vlaate/DobsonianDSC/dobDSC-back.jpg

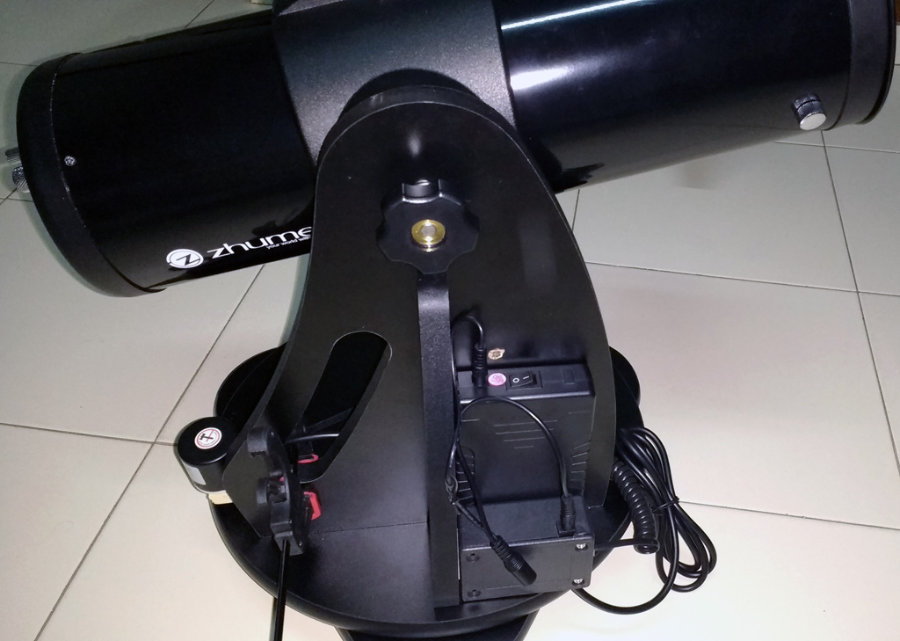
dobDSC-back.jpg
