vlaate/DobsonianDSC/dobDSC-front.jpg

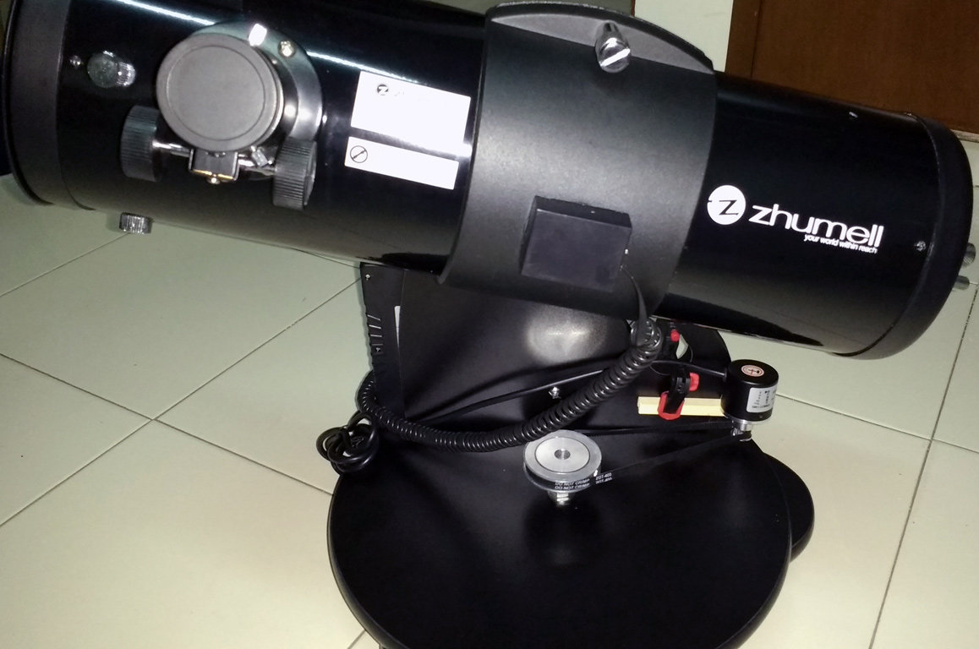
dobDSC-front.jpg
