vlaate/DobsonianDSC/dobDSC-upclose.jpg

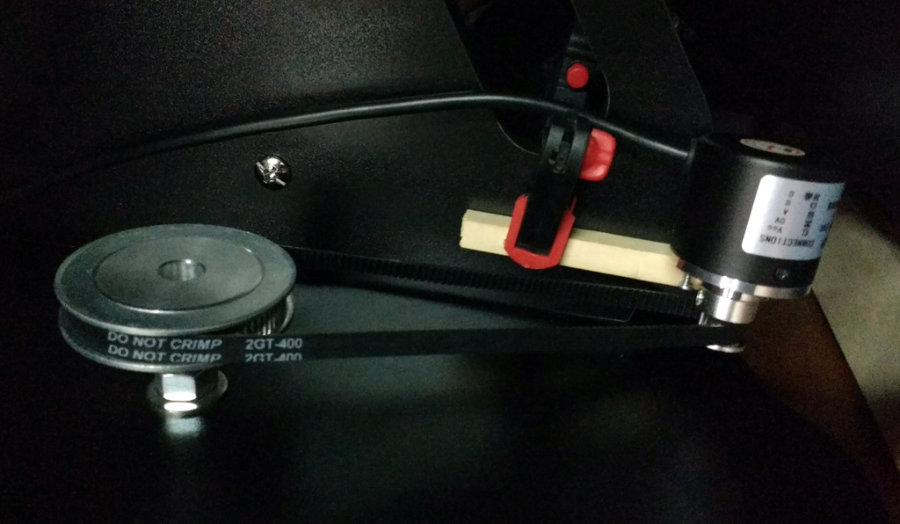
dobDSC-upclose.jpg
