vlaate/DobsonianDSC/img/9.png

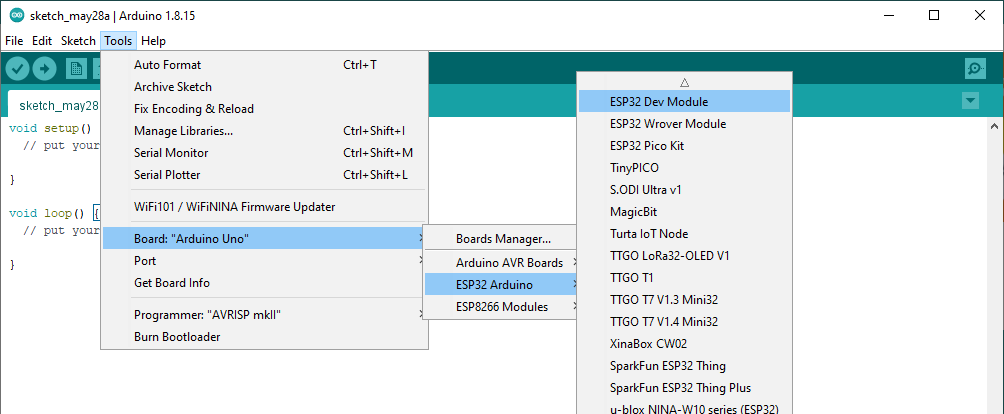
img/9.png
