vlaate/DobsonianDSC/img/12V_power_supply.jpg

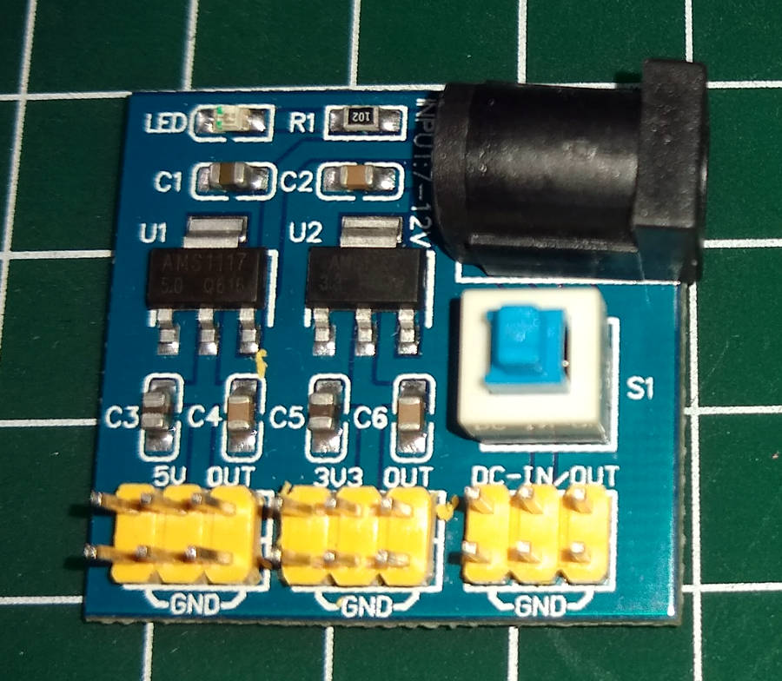
img/12V_power_supply.jpg
