vlaate/DobsonianDSC/img/AccelCircuit.jpg

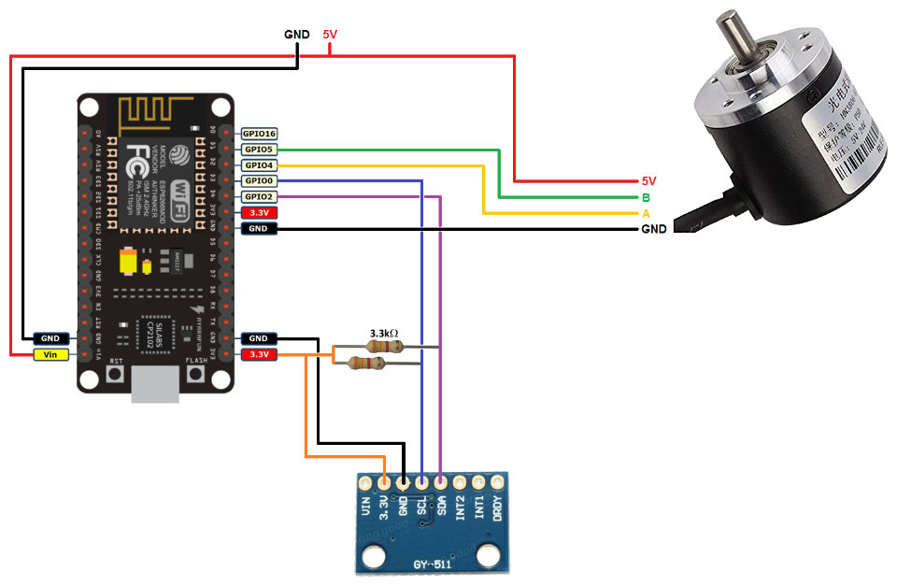
img/AccelCircuit.jpg
