vlaate/DobsonianDSC/img/Alt_encoder_3.jpg

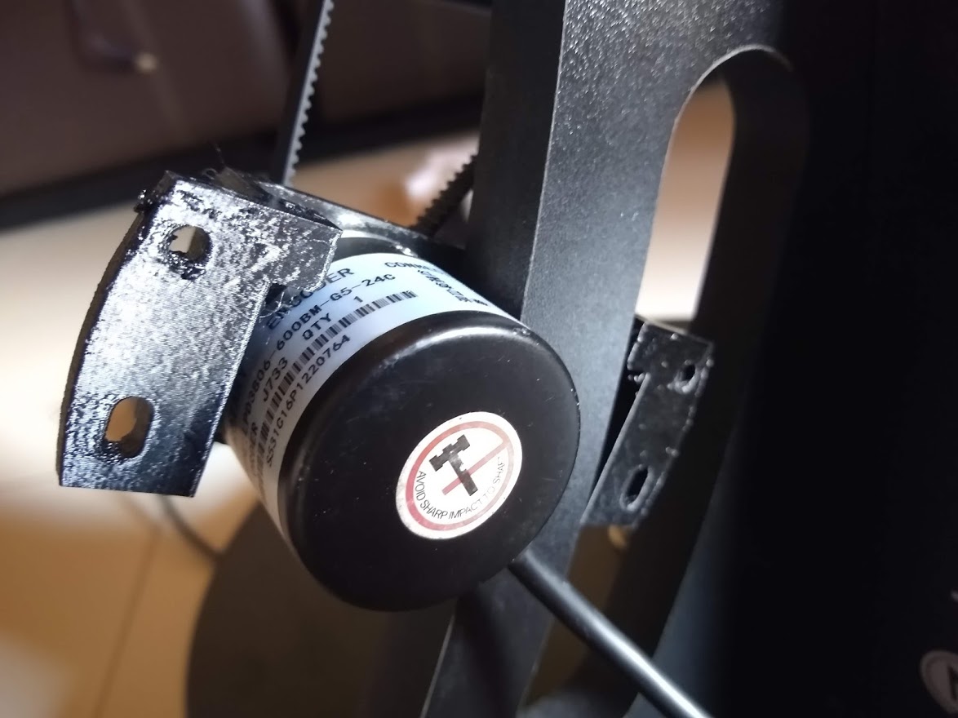
img/Alt_encoder_3.jpg
