vlaate/DobsonianDSC/img/connected_1.jpg

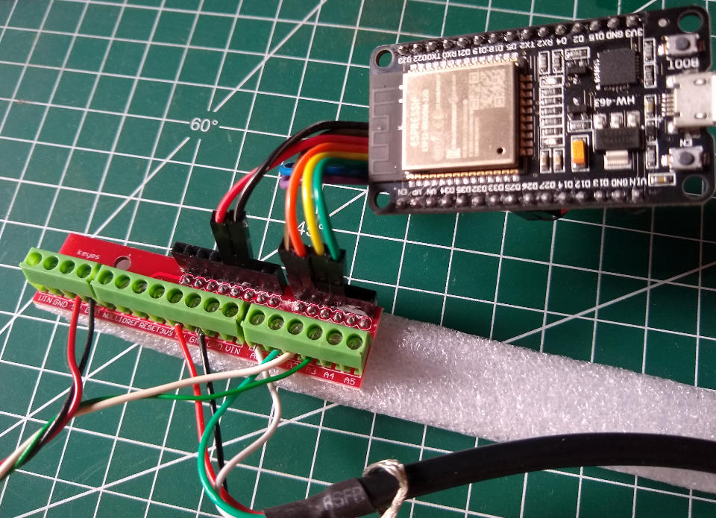
img/connected_1.jpg
