vlaate/DobsonianDSC/(threads)

Thread 2 (2020-02-08):

ESP12E circuit with 2 encoders?

TonyO94, 2020-02-08:
Vlaate,

I love your project and I hope you can offer me some advice.

I have a used GEM mount that came with encoders and cables but no DSC unit (I suspect it was an Orion Sky Wizard 3 or NGC-Max).  The two cables coming from the encoders merge into an eight-pin RJ-45 connector.

Rather than try to find some 20-year-old Sky Wizard unit on eBay or something, I wondered about a DIY project, and found your excellent solution involving wifi and SkySafari.

However, the circuit diagram you have for the NodeMCU ESP12E unit is for one encoder only, and for azimuth. (I understand that you use something different for altitude.)

Instead of a Dob, I have an equatorial mount with encoders directly reading RA and Dec (no need to convert). And I have two of them, not one.

Can you suggest how I would wire a circuit for the eight pins of the RJ-45 connector and two encoders to the NodeMCU? Would it be possible to wire them both into one NodeMCU?

I am a very experienced amateur astronomer and telescope builder, but I am not a coder or electronics guy. I am hoping I can figure things out from your excellent examples.

TonyO

TonyO94, 2020-02-08:
"Would it be possible to wire them both into one NodeMCU" -- looking more closely at your circuit diagram, I understand now that you are wiring both the one encoder for azimuth and the LSM303DLHC for altitude. So I assume it wouldn't be too different to do what I'm asking.

Here is the pin-out on the RJ-45 connector, which I believe is an NGC-Max standard...

1. Dec Ground (black)
2. Dec A channel (red)
3. Dec +5VDC power (green)
4. Dec B channel (yellow)
5. RA Ground (black)
6. RA A channel (red)
7. RA +5VDC power (green)
8. RA B channel (yellow)

TonyO

vlaate, 2020-02-08:
Hello TonyO.

Using two encoders is possible, and treeclimber from CloudyNights did it, see here:

https://www.cloudynights.com/topic/589521-37-dobsonian-dsc-for-diy-makers/page-5#entry8696835

Since Skysafari does support "Dual Encoders" in GEM mode, it should be feasible and not too hard, but it won't be trivial for someone without electronics/coding experience.

TonyO94, 2020-02-08:
Thank you. Fortunately, I have a couple of friends who know their way around a soldering iron, so I might be able to make this happen.

Thread 3 (2020-08-20):

Dobson 12 Push to

TigerClaw33, 2020-08-20:
Hi,
I bought a Skywatcher 300PX 12 inch flextube and would like to use a push to. But there are only one or two compatible kits and expensive. Would your project also work with my Dobson? Some kits are compatible with 8 till 12 inch. But I cannot believe that because it also depends on size. So do I have to make some changes to your code and would it also work with encoders with more steps ?

vlaate, 2020-08-20:
It works on my Skywaycher 10" (254mm) collapsible dobsonian, which is just a little smaller than yours. I would not have been able to find galaxies in Leo without this.
You can see pictures here:
[https://www.cloudynights.com/topic/589521-37-dobsonian-dsc-for-diy-makers/page-4#entry8335591](https://www.cloudynights.com/topic/589521-37-dobsonian-dsc-for-diy-makers/page-4#entry8335591)

The project aimed to get a resolution similar to that of a 10" Skywaycher go-to dob, so the chosen ratio of the GT2 pulleys (and accompanying code) was meant to replicate that. You'll find that horizontal resolution is quite enough for 12" dobs. The bigger limitation is the use of accelerometer for altitude: while the accelerometer is easier to install and remove from the tube of a collapsible Skywatcher (without even any permanent scar), the accelerometer is just not as precise as an altitude encoder would be. It also makes proper leveling of the dob base even more important.

TigerClaw33, 2020-08-20:
Ok nice. I will order all necessary parts because is most cheaper than a lot for 200 euro.

And I have 3d printers so it will be very easy. I will try it for your project and hope I will be able to make it work.

vlaate, 2020-08-20:
The main difference is that installing an encoder for azimuth requires intrusive surgery of the dob, while the accelerometer can be just taped to the tube.

But the encoder offers a repeatable and instant measurement, while the accelerometer catches some "noise" and smoothing it down brings a little delay.

You can find the whole discussion about the differences and the opinions of other people who have tried it in the cloudy nights [https://www.cloudynights.com/topic/589521-37-dobsonian-dsc-for-diy-makers](forum)

TigerClaw33, 2020-08-20:
Ok thank you.btw: did you use the ESP V3? Because in Germany they don't write if this is E-12. I have st home Adafruit ESP8266 feather huzzah. Maybe it will work with this.

I hope that 12 inch will not make a problem because theoretically I have smaller movement than you because Thai telescope size.

Thread 4 (2020-08-25):

WIFI - Connection not possible

TigerClaw33, 2020-08-25:
Hi,

I checkt my ESP8266 WIFI with an example and it is working fine. I bought the same device as you and flashed your code but with your code I cannot see the Access Point.

Everything was fine with flashing:

`Executable segment sizes:
IROM   : 254980          - code in flash         (default or ICACHE_FLASH_ATTR)
IRAM   : 28600   / 32768 - code in IRAM          (ICACHE_RAM_ATTR, ISRs...)
DATA   : 1276  )         - initialized variables (global, static) in RAM/HEAP
RODATA : 1064  ) / 81920 - constants             (global, static) in RAM/HEAP
BSS    : 25960 )         - zeroed variables      (global, static) in RAM/HEAP
Der Sketch verwendet 285920 Bytes (27%) des Programmspeicherplatzes. Das Maximum sind 1044464 Bytes.
Globale Variablen verwenden 28300 Bytes (34%) des dynamischen Speichers, 53620 Bytes für lokale Variablen verbleiben. Das Maximum sind 81920 Bytes.
esptool.py v2.8
Serial port COM3
Connecting....
Chip is ESP8266EX
Features: WiFi
Crystal is 26MHz
MAC: 8c:aa:b5:04:65:7a
Uploading stub...
Running stub...
Stub running...
Configuring flash size...
Auto-detected Flash size: 4MB
Compressed 290080 bytes to 212362...
Wrote 290080 bytes (212362 compressed) at 0x00000000 in 19.4 seconds (effective 119.5 kbit/s)...
Hash of data verified.

Leaving...
Hard resetting via RTS pin...
`
I didn't change the standard Ip (1.2.3.4) or something like that. Everything is original from github.

vlaate, 2020-08-25:
The code requires the rest of the circuit. It won't work on a naked NodeMCU/ESP8266.

If there is a problem initializing the i2c bus, it may not get to the point where it sets up the wifi.

If you are getting this problem with the circuit in place, uncomment line #141 "//  i2cscan();" and check the messages on the serial console to see what's happening
