vlaate/DobsonianDSC/(commit log)

2017-09-07 Corrected SDA and SCL wiring to match the schematic
    Corrected SDA and SCL wiring to match the schematic
    [DobsonianDSC.ino]
2017-09-09 library clarifications
    clarifications on the LSM303 and Encoder libraries used
2018-05-05 Support 'H' command - return encoders' resolution.
2018-07-24 clarification of pull-up resistor connection
    clarification of pull-up resistor connection
2021-05-27 Rename DobsonianDSC.ino to DobsonianDSC/DobsonianDSC.ino
    Moved to organize the introduction of the ESP32 version
2021-05-27 Create ESP32_DSC.ino
    New version of the DSC supporting dual encoders, bluetooth and web configuration page
2021-05-27 Added dual encoders, Bluetooth and web config
    Added ESP32 version version of the DSC supporting dual encoders, bluetooth and a web configuration page
2021-05-27 initial documentation for ESP32 version
2021-05-27 initial documentation of ESP32 version
2021-05-27 Circuit for the ESP32 version
2021-05-27 Documented the dual encoder circuit for ESP32
2021-05-27 Documented circuit for dual encoder ESP32 version
2021-05-27 documenting new ESP32 version
2021-05-27 documenting ESP32 version
2021-05-28 Adding guide for Arduino IDE
2021-05-28 Initial version of Arduino beginners guide
2021-05-31 updated circuit
2021-05-31 Circuit and components images for docs
2021-05-31 Initial version of circuit build guide
2021-05-31 updated circuit build guide
2021-05-31 improvements to circuit building guide
2021-06-03 improved the circuit guide
2021-06-09 Fixed bug reported by OskyBear
    the readings from ESP32Encoder are of type int64_t so the correct sprintf token for them is "%lld"
    [DobsonianDSC.ino]
